tomTTFB/rj45-cable-tester/rj45-tester/rj45-tester.kicad_sch

## KiCad design rj45-tester/rj45-tester.kicad_sch (2026-11-09)

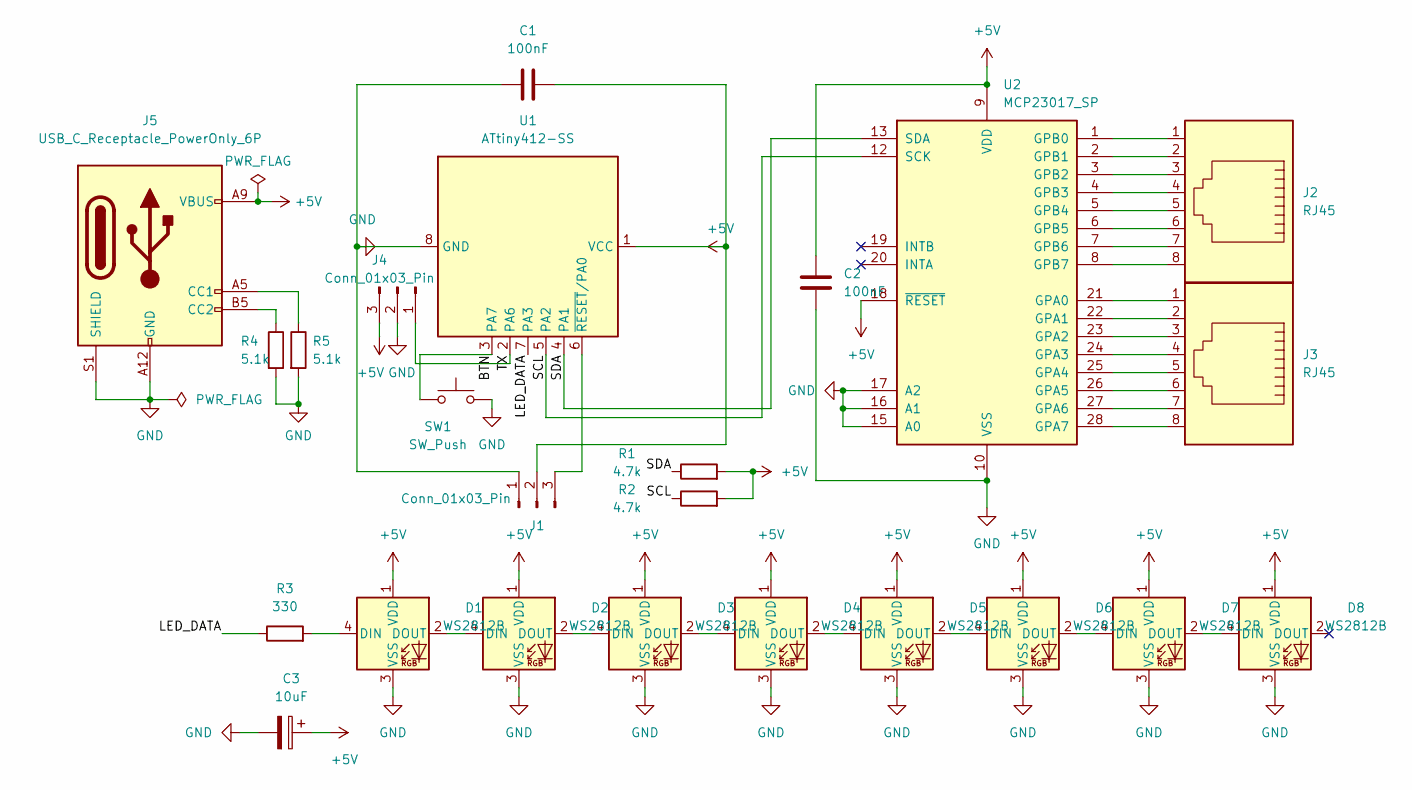
[picture p1: schematic rj45-tester.kicad_sch]

Parts:
C1, C2: 100nF; C_Disc_D5.1mm_W3.2mm_P5.00mm; Part Number K104M20X7RH53H5
C3: 10uF; CP_Radial_D5.0mm_P2.00mm; Part Number ESC106M063AC3AA
D1, D2, D3, D4, D5, D6, D7, D8: WS2812B; LED_WS2812B_PLCC4_5.0x5.0mm_P3.2mm; Part Number IN-PI55TATPRPGPB
J1, J4: Conn_01x03_Pin; PinHeader_1x03_P2.54mm_Vertical; Part Number G800LR305018EU
J2, J3: RJ45; RJ45_Amphenol_54602-x08_Horizontal; Part Number 54602-908LF
J5: USB_C_Receptacle_PowerOnly_6P; USB_C_Receptacle_GCT_USB4125-xx-x_6P_TopMnt_Horizontal; Part Number USB4125-GF-A
R1, R2: 4.7k; R_Axial_DIN0207_L6.3mm_D2.5mm_P10.16mm_Horizontal; Part Number MFR-25FBF52-4K7
R3: 330; R_Axial_DIN0207_L6.3mm_D2.5mm_P10.16mm_Horizontal; Part Number MFR-25FBF52-330R
R4, R5: 5.1k; R_Axial_DIN0207_L6.3mm_D2.5mm_P10.16mm_Horizontal; Part Number MFR-25FBF52-5K1
SW1: SW_Push; SW_PUSH_6mm; Part Number B3W-1002
U1: ATtiny412-SS; SOIC-8_3.9x4.9mm_P1.27mm; Part Number ATTINY412-SSN
U2: MCP23017_SP; DIP-28_W7.62mm; Part Number MCP23017-E/SP

Connections:
+5V: C1.2, C2.1, C3.1, D1.1 (VDD), D2.1 (VDD), D3.1 (VDD), D4.1 (VDD), D5.1 (VDD), D6.1 (VDD), D7.1 (VDD), D8.1 (VDD), J1.2, J4.3, J5.A9 (VBUS), J5.B9 (VBUS), R1.2, R2.2, U1.1 (VCC), U2.9 (VDD), U2.18 (~RESET)
BTN: SW1.1, U1.3 (PA7)
GND: C1.1, C2.2, C3.2, D1.3 (VSS), D2.3 (VSS), D3.3 (VSS), D4.3 (VSS), D5.3 (VSS), D6.3 (VSS), D7.3 (VSS), D8.3 (VSS), J1.1, J4.2, J5.A12 (GND), J5.B12 (GND), J5.S1 (SHIELD), R4.2, R5.2, SW1.2, U1.8 (GND), U2.10 (VSS), U2.15 (A0), U2.16 (A1), U2.17 (A2)
LED_DATA: R3.1, U1.7 (PA3)
unnamed: D1.2 (DOUT), D2.4 (DIN)
unnamed: D1.4 (DIN), R3.2
unnamed: D2.2 (DOUT), D3.4 (DIN)
unnamed: D3.2 (DOUT), D4.4 (DIN)
unnamed: D4.2 (DOUT), D5.4 (DIN)
unnamed: D5.2 (DOUT), D6.4 (DIN)
unnamed: D6.2 (DOUT), D7.4 (DIN)
unnamed: D7.2 (DOUT), D8.4 (DIN)
unnamed: J1.3, U1.6 (~RESET/PA0)
unnamed: J2.1, U2.1 (GPB0)
unnamed: J2.2, U2.2 (GPB1)
unnamed: J2.3, U2.3 (GPB2)
unnamed: J2.4, U2.4 (GPB3)
unnamed: J2.5, U2.5 (GPB4)
unnamed: J2.6, U2.6 (GPB5)
unnamed: J2.7, U2.7 (GPB6)
unnamed: J2.8, U2.8 (GPB7)
unnamed: J3.1, U2.21 (GPA0)
unnamed: J3.2, U2.22 (GPA1)
unnamed: J3.3, U2.23 (GPA2)
unnamed: J3.4, U2.24 (GPA3)
unnamed: J3.5, U2.25 (GPA4)
unnamed: J3.6, U2.26 (GPA5)
unnamed: J3.7, U2.27 (GPA6)
unnamed: J3.8, U2.28 (GPA7)
unnamed: J5.A5 (CC1), R5.1
unnamed: J5.B5 (CC2), R4.1
SCL: R2.1, U1.5 (PA2), U2.12 (SCK)
SDA: R1.1, U1.4 (PA1), U2.13 (SDA)
TX: J4.1, U1.2 (PA6)
