tomTTFB/rj45-cable-tester/(commit log)

2026-11-09 finished schematic, footprints and part list
    [rj45-tester.kicad_pcb, rj45-tester.kicad_sch]
2026-11-09 add gitignore, remove kicad backup and cache files
